GadgetReboot/ESP32-S3_Drum_Midi_Controller/Schematic_MIDI_Drum_Trigger.pdf

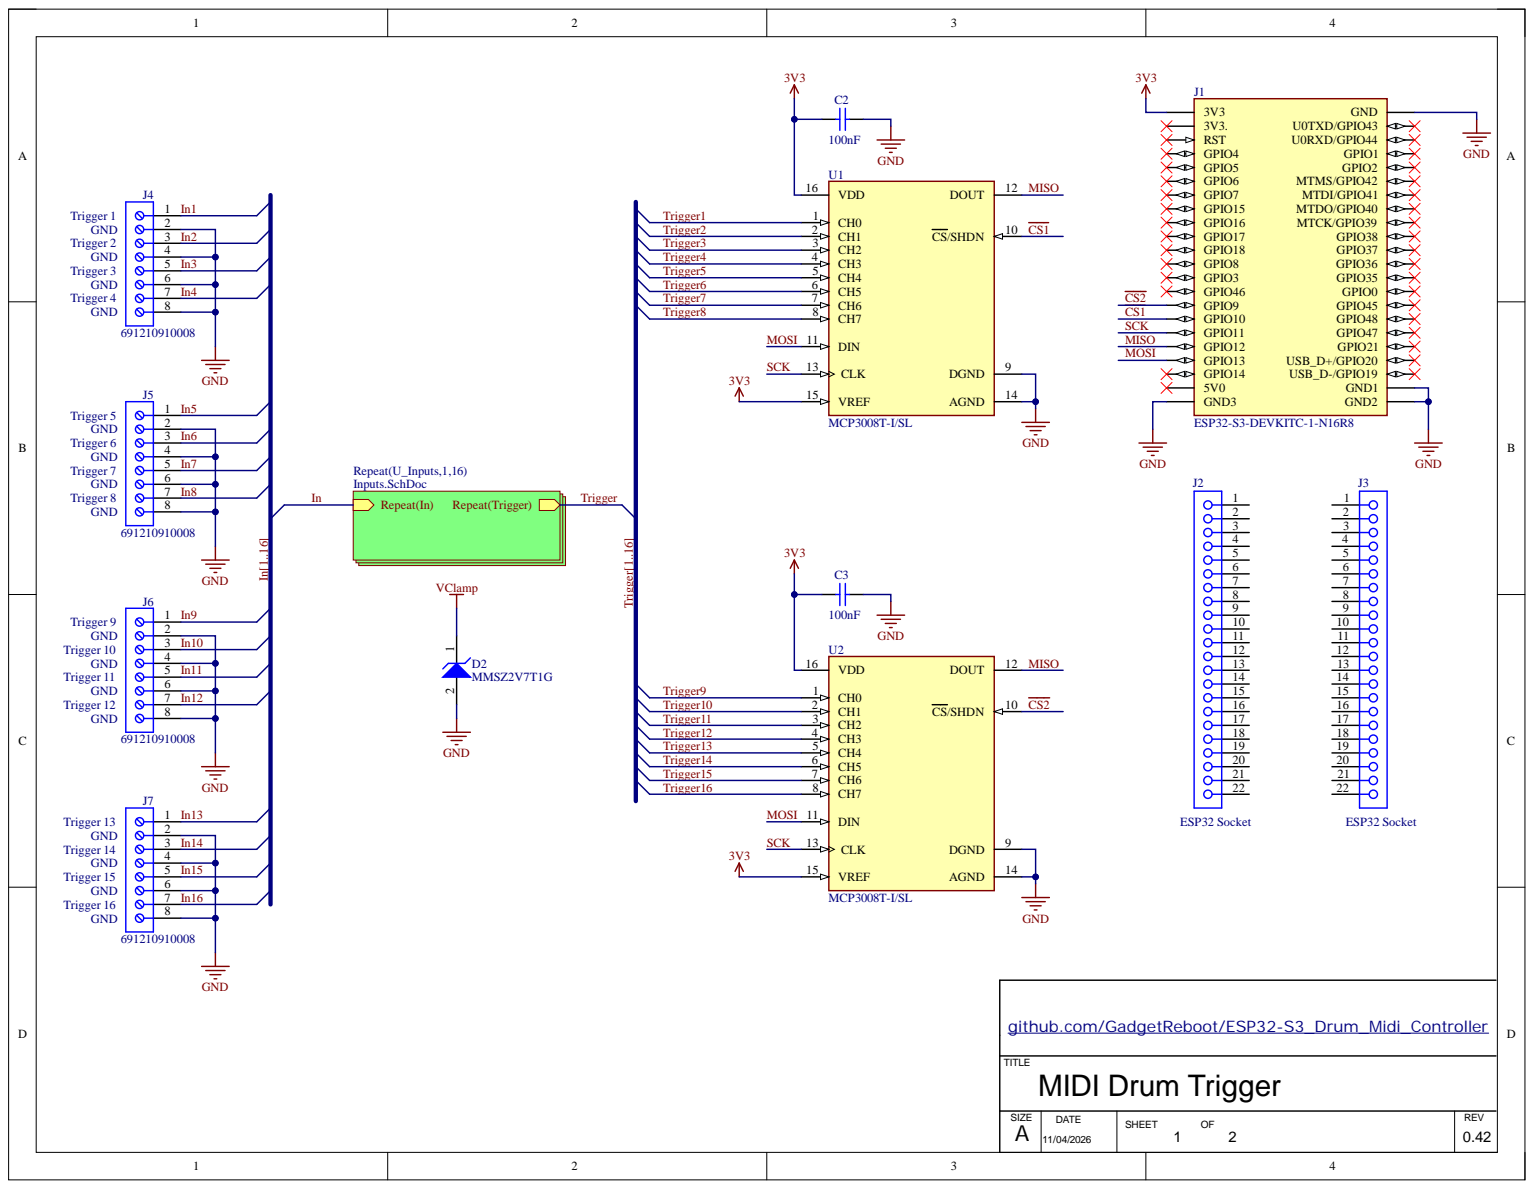
[picture p3: page 1]

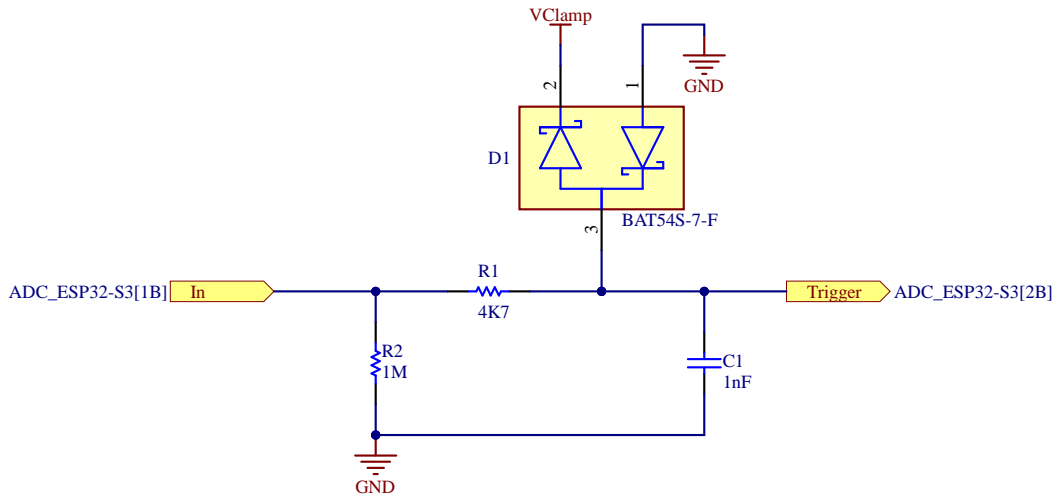
[picture p4: page 2]
