GadgetReboot/ESP32-S3_Drum_Midi_Controller/sketch/Midi_Drum_Controller/midi_percussion_notes.h

#pragma once

#define AcousticBassDrum    35
#define BassDrum1           36
#define SideStick           37
#define AcousticSnare       38
#define HandClap            39
#define ElectricSnare       40
#define LowFloorTom         41
#define ClosedHiHat         42
#define HighFloorTom        43
#define PedalHiHat          44
#define LowTom              45
#define OpenHiHat           46
#define LowMidTom           47
#define HiMidTom            48
#define CrashCymbal1        49
#define HighTom             50
#define RideCymbal1         51
#define ChineseCymbal       52
#define RideBell            53
#define Tambourine          54
#define SplashCymbal        55
#define Cowbell             56
#define CrashCymbal2        57
#define Vibraslap           58
#define RideCymbal2         59
#define HiBongo             60
#define LowBongo            61
#define MuteHiConga         62
#define OpenHiConga         63
#define LowConga            64
#define HighTimbale         65
#define LowTimbale          66
#define HighAgogo           67
#define LowAgogo            68
#define Cabasa              69
#define Maracas             70
#define ShortWhistle        71
#define LongWhistle         72
#define ShortGuiro          73
#define LongGuiro           74
#define Claves              75
#define HiWoodBlock         76
#define LowWoodBlock        77
#define MuteCuica           78
#define OpenCuica           79
#define MuteTriangle        80
#define OpenTriangle        81
